KSeechan/Portable-Oscilloscope/Final Oscilloscope Images/3.jpg

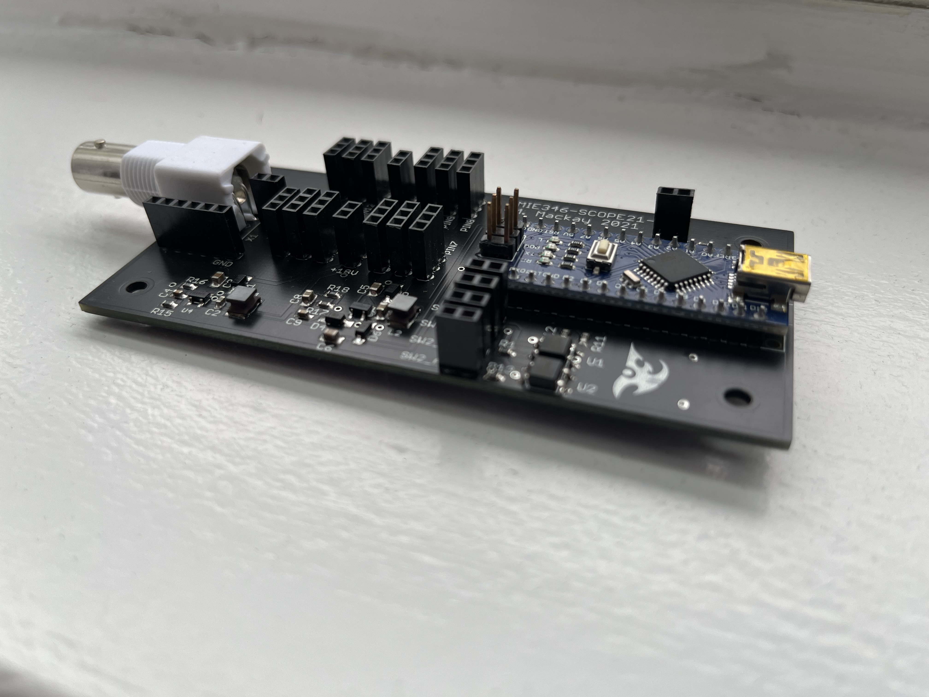
Final Oscilloscope Images/3.jpg
