KSeechan/Portable-Oscilloscope/Circuit and Board Images/both layers.JPG

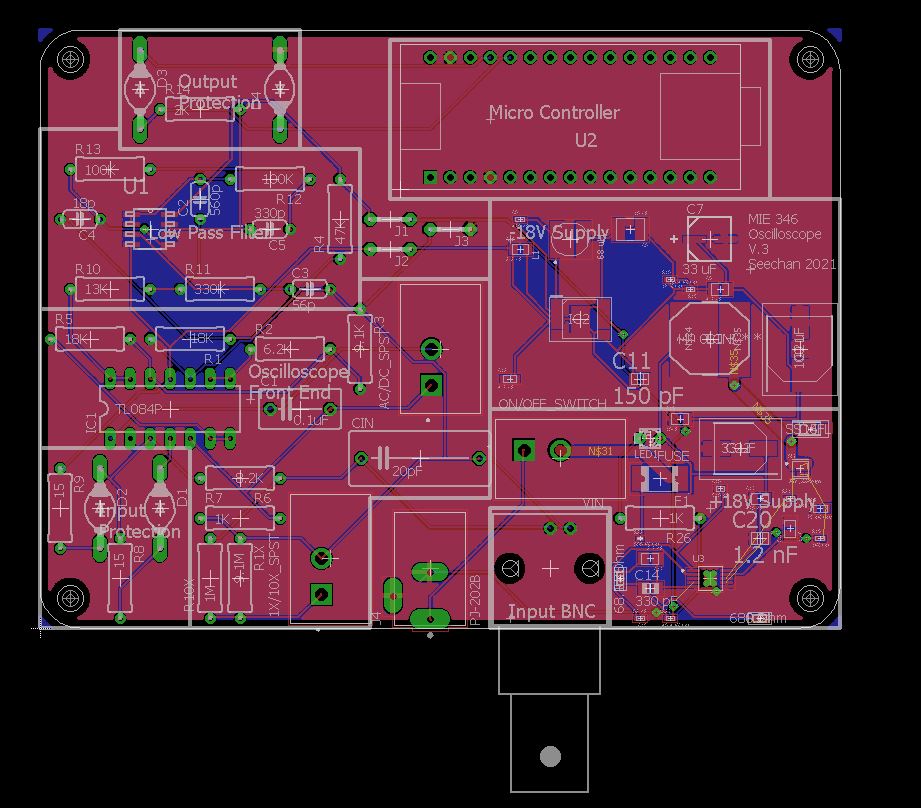
Circuit and Board Images/both layers.JPG
