KSeechan/Portable-Oscilloscope/README.md

# Portable-Oscilloscope
Design of a Portable Oscilloscope
