KSeechan/Portable-Oscilloscope/Circuit and Board Images/16 Bottom Layer.JPG

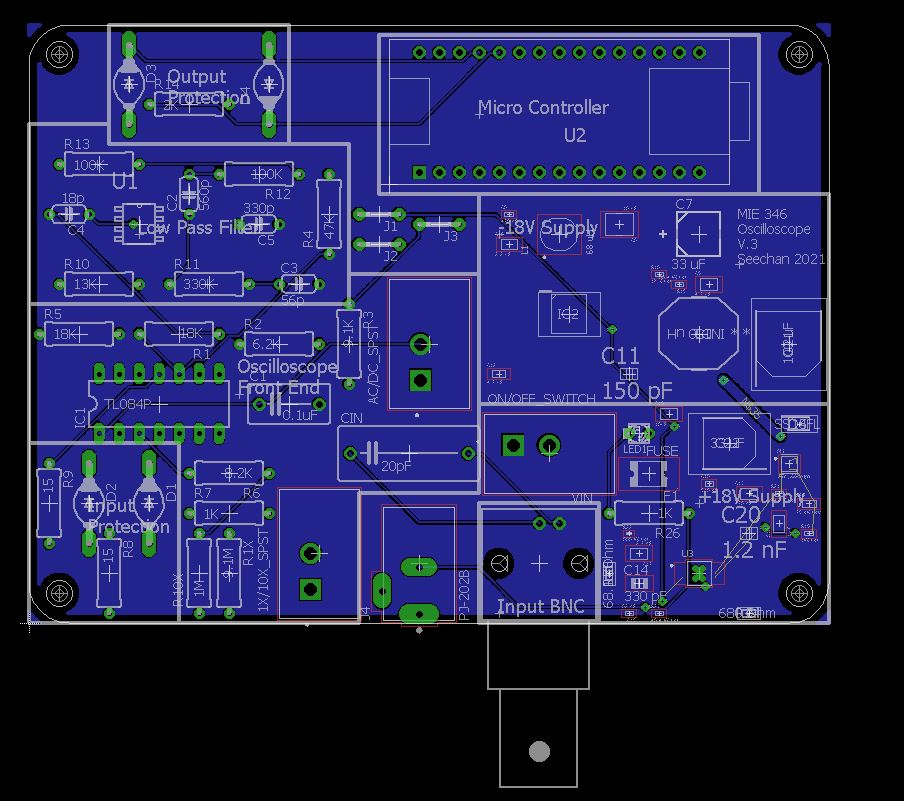
Circuit and Board Images/16 Bottom Layer.JPG
