KSeechan/Portable-Oscilloscope/Circuit and Board Images/Schematic.JPG

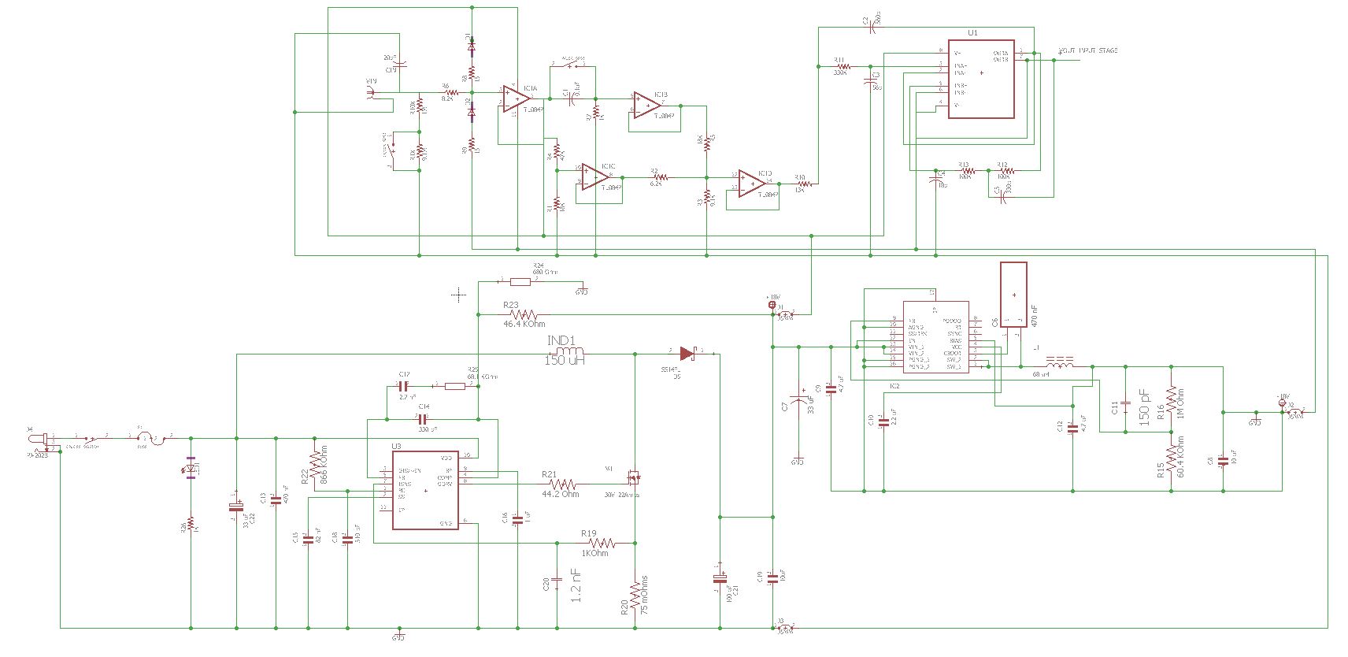
Circuit and Board Images/Schematic.JPG
