KSeechan/Portable-Oscilloscope/Final Oscilloscope Images/1.jpg

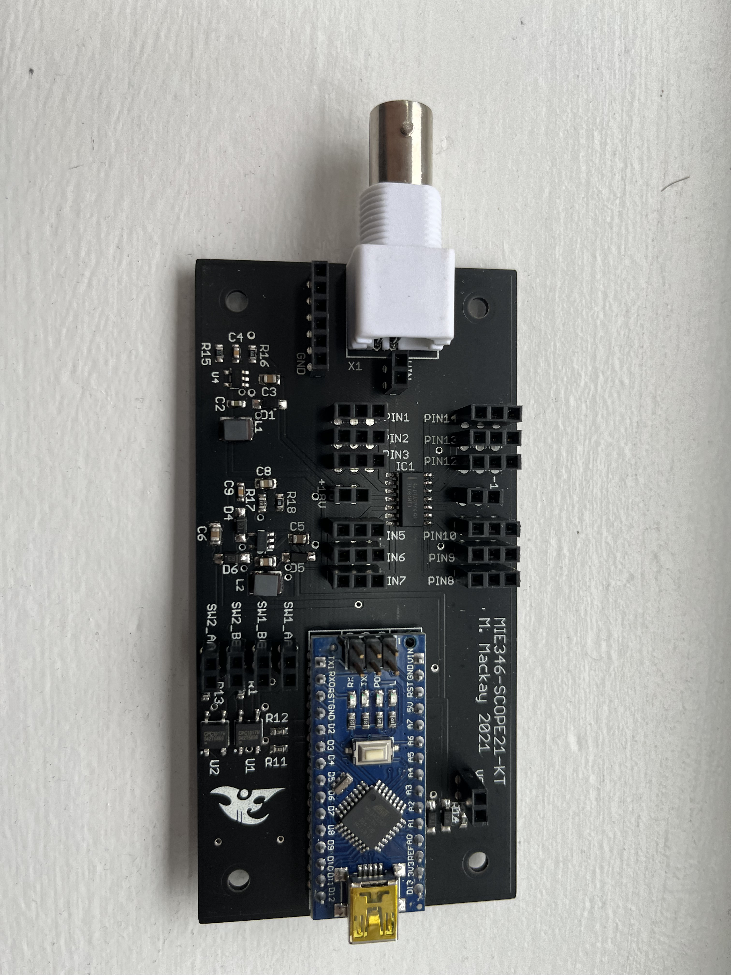
Final Oscilloscope Images/1.jpg
