KSeechan/Portable-Oscilloscope/Final Oscilloscope Images/2.jpg

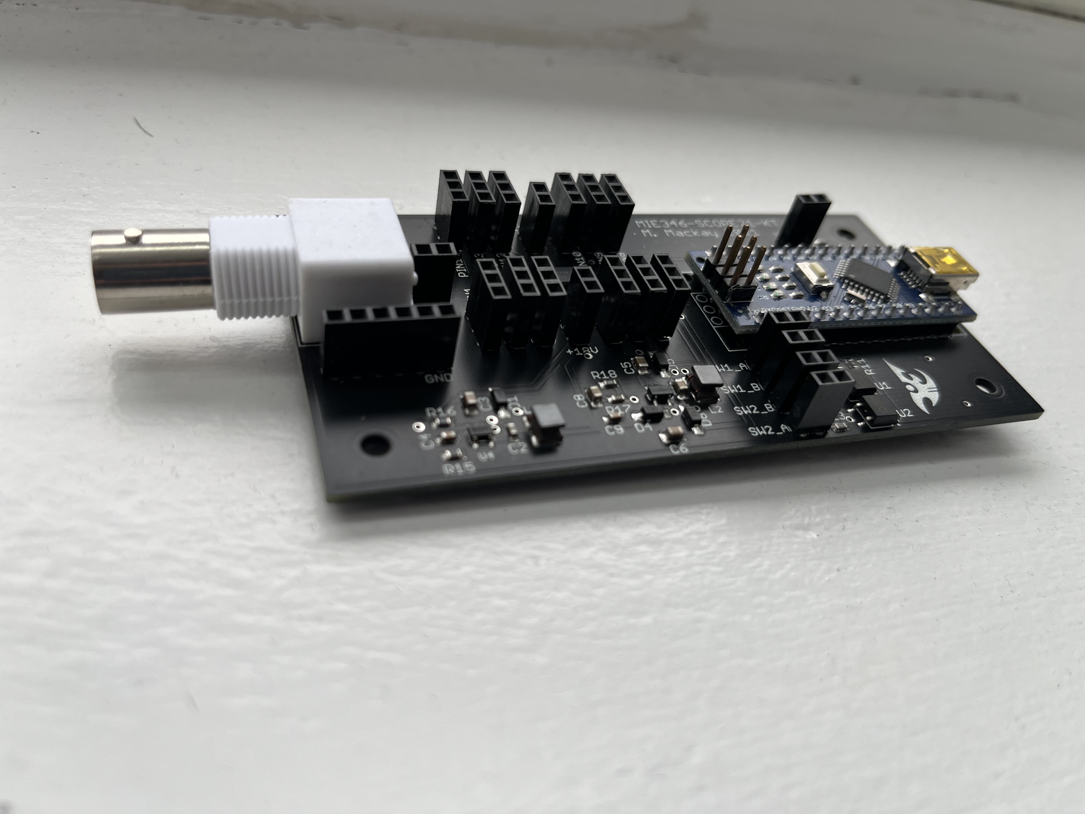
Final Oscilloscope Images/2.jpg
