KSeechan/Portable-Oscilloscope/Eagle Files/Oscilloscope V3.brd

## EAGLE design Eagle Files/Oscilloscope V3.brd (2023-03-03)

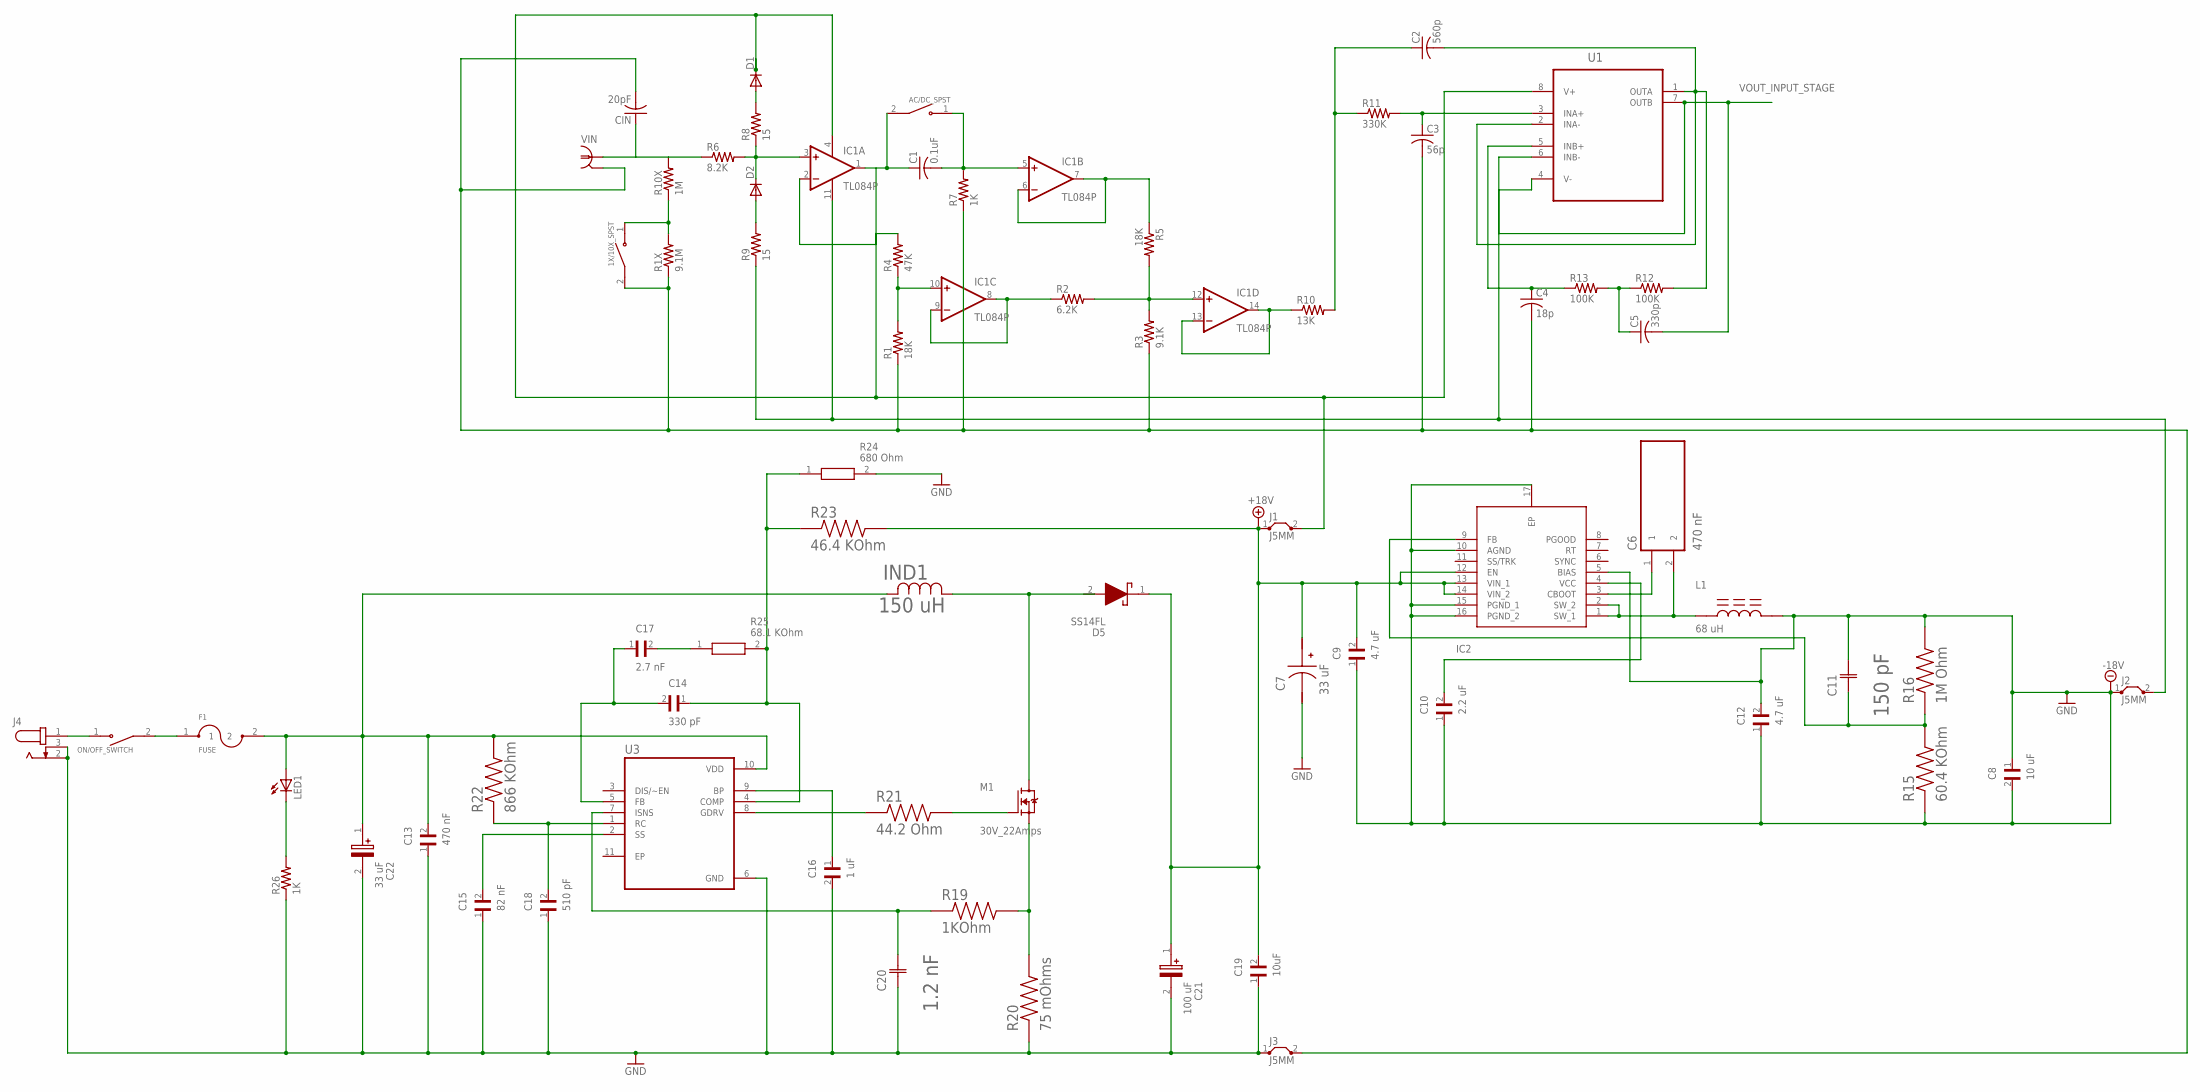
[picture p13: schematic Oscilloscope V3.sch, sheet 1, Input Section]

Parts:
1X/10X_SPST: GF-123-0054; SW_GF-123-0054
AC/DC_SPST: GF-123-0054; SW_GF-123-0054
C1: 0.1uF; C075-052X106
C2: 560p; C050-024X044
C3: 56p; C050-024X044
C4: 18p; C050-024X044
C5: 330p; C050-024X044
C6: 470 nF; CAPC1005X55N
C7: 33 uF; SM_RADIAL_C
C8: 10 uF; ANTC3225X280N
C9: 4.7 uF; CAPC2012X145N
C10: 2.2 uF; CAPC2012X135N
C11: 150 pF; CAPC2013X88N
C12: 4.7 uF; CAPC1608X90N
C13: 470 nF; CAPC2012X95N
C14: 330 pF; CAPC2012X140N
C15: 82 nF; CAPC1005X55N
C16: 1 uF; CAPC2012X88N
C17: 2.7 nF; CAPC2012X75N
C18: 510 pF; CAPC1005X55N
C19: 10uF; CAPC2012X140N
C20: 1.2 nF; CAPC2013X88N
C21: 100 uF; CAPAE830X1050N
C22: 33 uF; CAPAE660X610N
CIN: 20pF; C150-072X183
D1, D2: DIODE-DO204-10; DO204-10
D5: SS14FL; SODFL3617X108N
F1: FUSE; FUSM4632X75
IC1: TL084P; DIL14
IC2: LM43601PWPR; SOP65P640X120-17N
IND1: 150 uH; IND_NPI105C_NIC
J1, J2, J3: J5MM; 05
J4: PJ-202B; CUI_PJ-202B
L1: 68 uH; IND_SDR0403-680KL
LED1: LED_ELD260; LED_LD260
M1: 30V_22Amps; TRANS_CSD17571Q2
ON/OFF_SWITCH: GF-123-0054; SW_GF-123-0054
R1, R5: 18K; 0309/10
R1X: 9.1M; 0309/10
R2: 6.2K; 0309/10
R3: 9.1K; 0309/10
R4: 47K; 0309/10
R6: 8.2K; 0309/10
R7, R26: 1K; 0309/10
R8, R9: 15; 0309/10
R10: 13K; 0309/10
R10X: 1M; 0309/10
R11: 330K; 0309/10
R12, R13: 100K; 0309/10
R15: 60.4 KOhm; RESC1005X40N
R16: 1M Ohm; RESC1005X40N
R19: 1KOhm; RESC1005X40N
R20: 75 mOhms; RESC1608X55N
R21: 44.2 Ohm; RESC1005X40N
R22: 866 KOhm; RESC0603X26N
R23: 46.4 KOhm; RESC1005X40N
R24: 680 Ohm; RESC1608X55N
R25: 68.1 KOhm; RESC1608X55N
U1: ADA4062-2BRZ; SOIC127P600X175-8N
U3: TPS40211DGQR; IC_XTR111AIDGQR
VIN: 1-227161-6; AMP_227161

Connections:
+18V: C7.1 (+), C9.2, C19.2, C21.1 (+), D5.1 (K), IC2.12 (EN), IC2.13 (VIN_1), IC2.14 (VIN_2), J1.1, R23.2
-18V: C8.1, C8.2, C9.1, C10.1, C11.2 (C2), C12.1, C12.2, IC2.5 (BIAS), IC2.10 (AGND), IC2.15 (PGND_1), IC2.16 (PGND_2), IC2.17 (EP), J2.1, L1.2, R15.1, R16.2
GND: C7.2 (-), C13.1, C15.1, C16.2, C18.1, C19.1, C20.1 (C1), C21.2 (-), C22.2 (-), J3.1, J4.2, J4.3, R20.1, R24.2, R26.1, U3.6 (GND); also elsewhere on the board
unnamed: CIN.1, R6.1, R10X.2, VIN.1
unnamed: 1X/10X_SPST.1, R1X.2, R10X.1
unnamed: AC/DC_SPST.1, C1.2, IC1.5 (+IN), R7.2
unnamed: AC/DC_SPST.2, C1.1, IC1.1 (OUT)
unnamed: IC1.6 (-IN), IC1.7 (OUT), R5.1
unnamed: IC1.8 (OUT), IC1.9 (-IN), R2.1
unnamed: IC1.10 (+IN), R1.2, R4.1
unnamed: IC1.12 (+IN), R2.2, R3.2, R5.2
unnamed: D2.C, IC1.3 (+IN), R6.2, R8.1
unnamed: IC1.13 (-IN), IC1.14 (OUT), R10.1
unnamed: D2.A, R9.2
unnamed: D1.A, R8.2
unnamed: C2.1, R10.2, R11.1
unnamed: C3.1, R11.2, U1.3 (INA+)
unnamed: C5.1, R12.1, R13.2
unnamed: C2.2, R12.2, U1.1 (OUTA), U1.2 (INA-)
unnamed: C14.2, C17.1, U3.5 (FB)
unnamed: C4.1, R13.1, U1.5 (INB+)
unnamed: C14.1, R23.1, R24.1, R25.2, U3.4 (COMP)
unnamed: C17.2, R25.1
unnamed: C13.2, C22.1 (+), F1.2, IND1.2, LED1.A, R22.2, U3.10 (VDD)
unnamed: C16.1, U3.9 (BP)
unnamed: C18.2, R22.1, U3.1 (RC)
unnamed: C15.2, U3.2 (SS)
unnamed: C20.2 (C2), R19.1, U3.7 (ISNS)
unnamed: R21.1, U3.8 (GDRV)
unnamed: M1.3 (G), R21.2
unnamed: F1.1, ON/OFF_SWITCH.2
unnamed: M1.4 (S), M1.8 (S), R19.2, R20.2
unnamed: LED1.K (C), R26.2
unnamed: C10.2, IC2.4 (VCC)
unnamed: IND1.1, M1.1 (D), M1.2 (D), M1.5 (D), M1.6 (D), M1.7 (D)
unnamed: D1.C, IC1.4 (V+)
unnamed: C11.1 (C1), IC2.9 (FB), R15.2, R16.1
unnamed: C6.1, IC2.3 (CBOOT)
unnamed: J1.2, R4.2, U1.8 (V+)
unnamed: IC1.11 (V-), J2.2, R9.1, U1.4 (V-)
unnamed: C6.2, IC2.1 (SW_1), IC2.2 (SW_2), L1.1
unnamed: J4.1, ON/OFF_SWITCH.1
unnamed: 1X/10X_SPST.2, C3.2, C4.2, CIN.2, J3.2, R1.1, R1X.1, R3.1, R7.1, VIN.2
VOUT_INPUT_STAGE: C5.2, U1.6 (INB-), U1.7 (OUTB); also elsewhere on the board

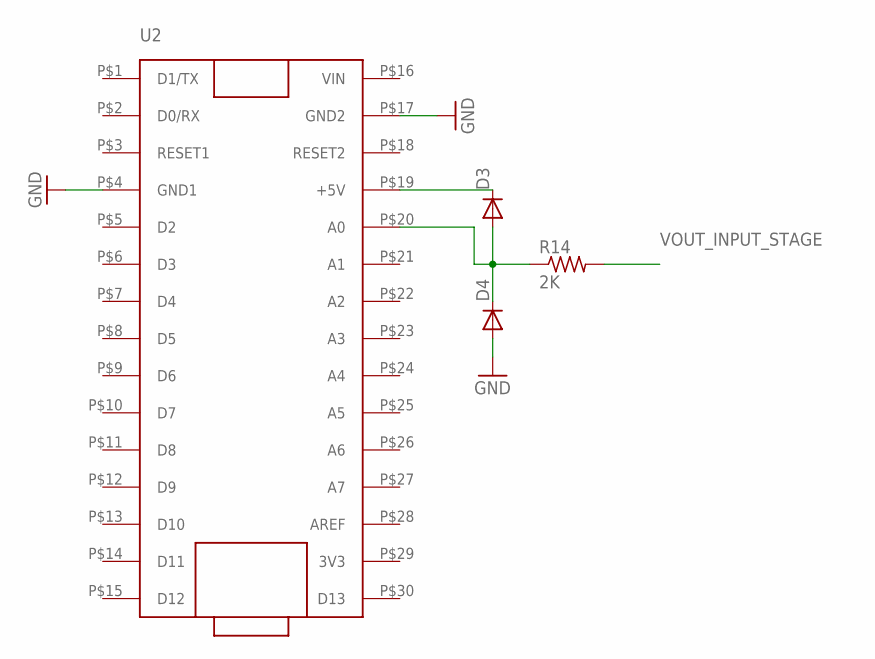
[picture p14: schematic Oscilloscope V3.sch, sheet 2, Micro Controller and Power Supply]

Parts:
D3, D4: DIODE-DO204-10; DO204-10
R14: 2K; 0309/10
U2: ARDUINO-NANO; NANO-PCB

Connections:
GND: D4.A, U2.P$4 (GND1), U2.P$17 (GND2); also elsewhere on the board
unnamed: D3.A, D4.C, R14.1, U2.P$20 (A0)
unnamed: D3.C, U2.P$19 (+5V)
VOUT_INPUT_STAGE: R14.2; also elsewhere on the board

Board: 2 copper layers, 72 parts (0 on the bottom side), 46 nets, no tracks yet.
