KSeechan/Portable-Oscilloscope/(commit log)

2023-03-03 PCB Board
    [Oscilloscope V3.brd]
2023-03-03 Gerber Files
2023-03-03 Pictures of Schematic and Board
2023-03-03 PCB Images
